alexandre-pereira/ws-trimmer/stl/bobine_ecrou.stl

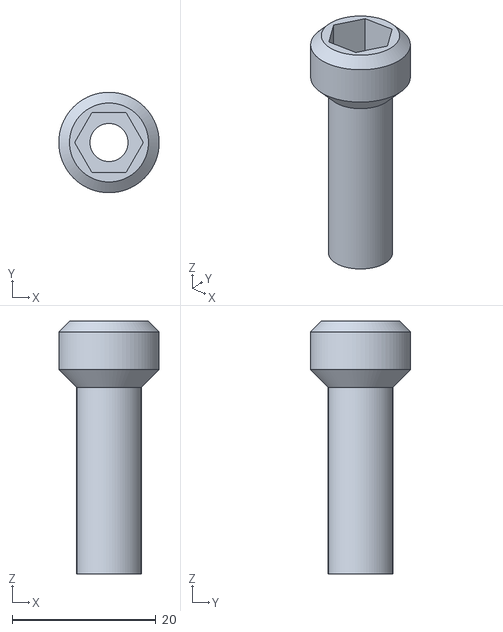
[picture p25: CAD file, 2026-10-21]
stl/bobine_ecrou.stl
14.0 x 14.0 x 35.2
