alexandre-pereira/ws-trimmer/stl/support_laser_leica_x3_x4.stl

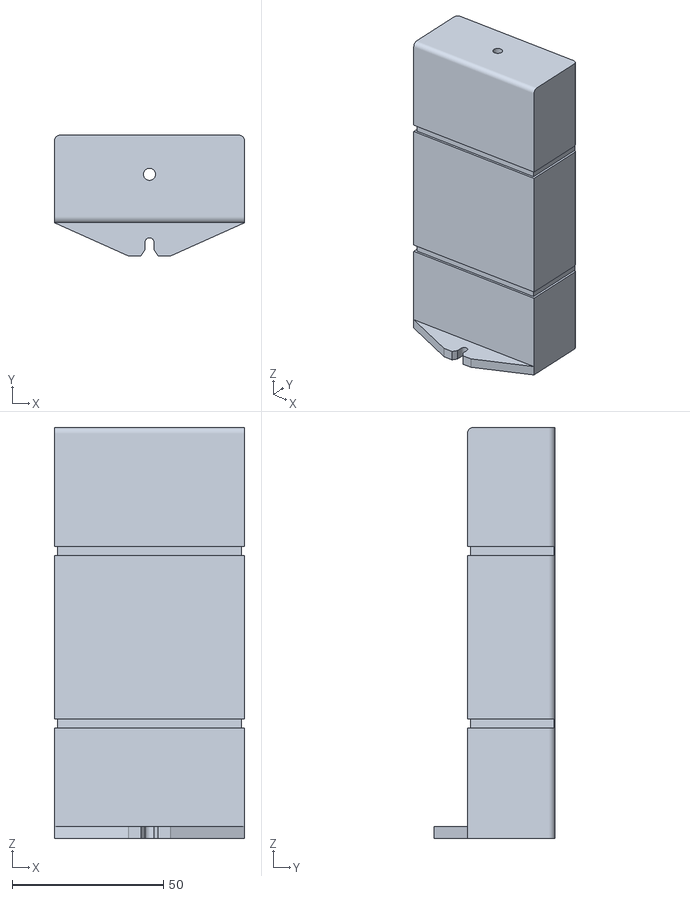
[picture p26: CAD file, 2026-10-21]
stl/support_laser_leica_x3_x4.stl
63.0 x 40.0 x 136.0
