alexandre-pereira/ws-trimmer/stl/support_laser_bosch_plm30.stl

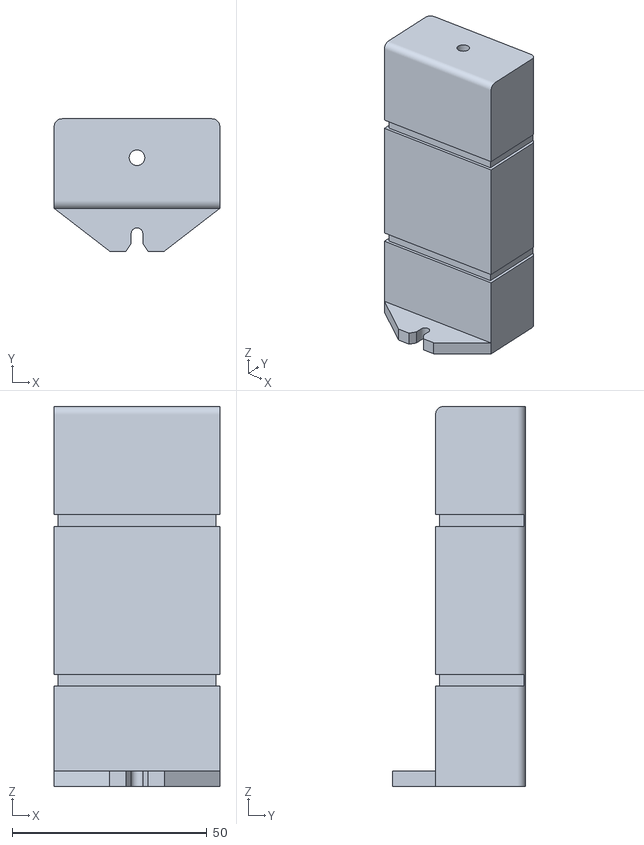
[picture p27: CAD file, 2026-10-21]
stl/support_laser_bosch_plm30.stl
42.5 x 34.0 x 97.5
