alexandre-pereira/ws-trimmer/stl/support_laser_bosch_glm80.stl

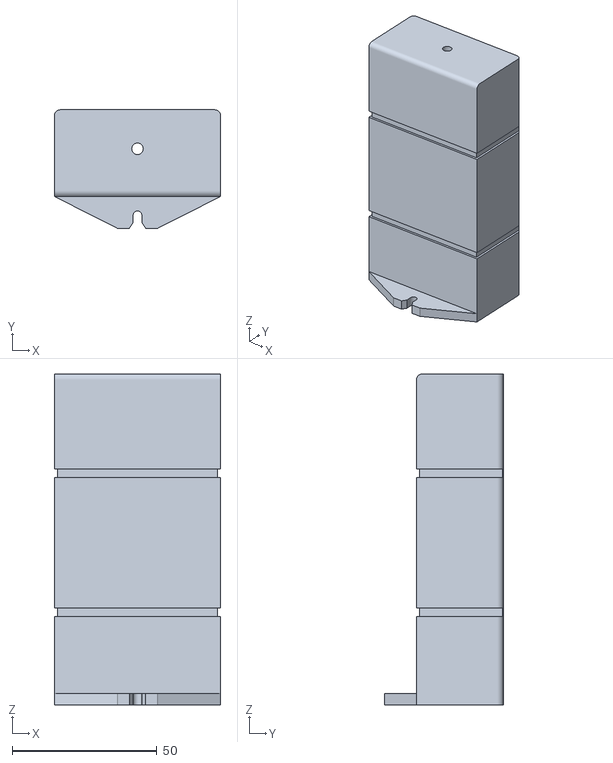
[picture p28: CAD file, 2026-10-21]
stl/support_laser_bosch_glm80.stl
57.5 x 41.0 x 114.5
