alexandre-pereira/ws-trimmer/stl/support_laser_leica_x1.stl

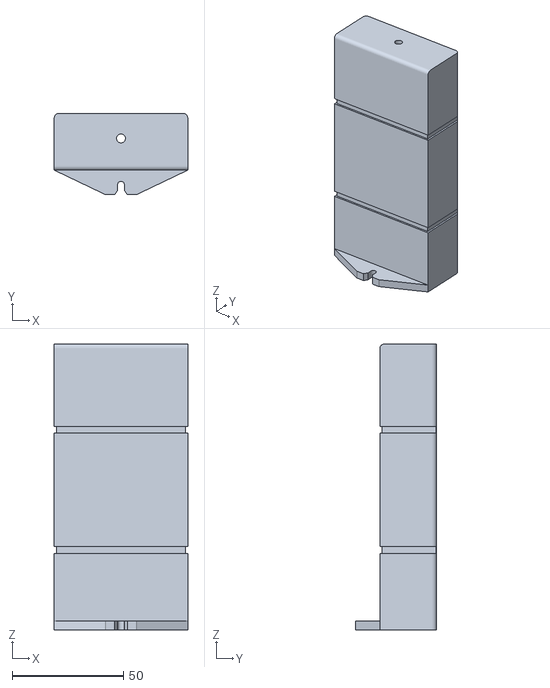
[picture p29: CAD file, 2026-10-21]
stl/support_laser_leica_x1.stl
60.0 x 36.5 x 128.5
