alexandre-pereira/ws-trimmer/stl/support_laser_bosch_glm100_150.stl

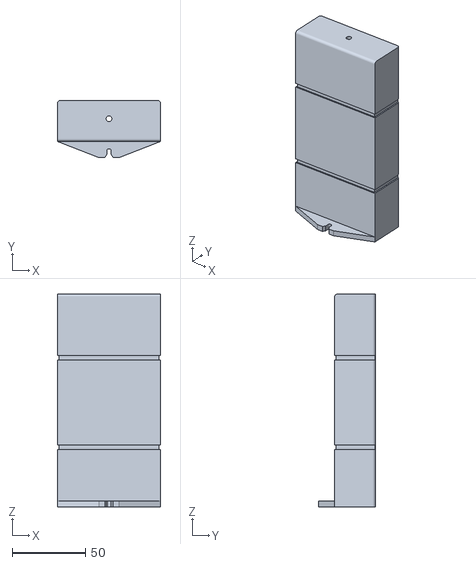
[picture p30: CAD file, 2026-10-21]
stl/support_laser_bosch_glm100_150.stl
70.5 x 39.0 x 145.5
