alexandre-pereira/ws-trimmer/stl/support_laser_bosch_plm70_27.stl

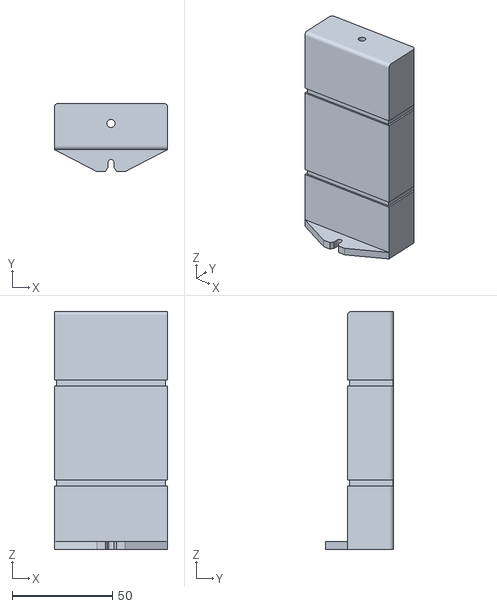
[picture p31: CAD file, 2026-10-21]
stl/support_laser_bosch_plm70_27.stl
56.5 x 34.0 x 118.5
