alexandre-pereira/ws-trimmer/stl/cible.stl

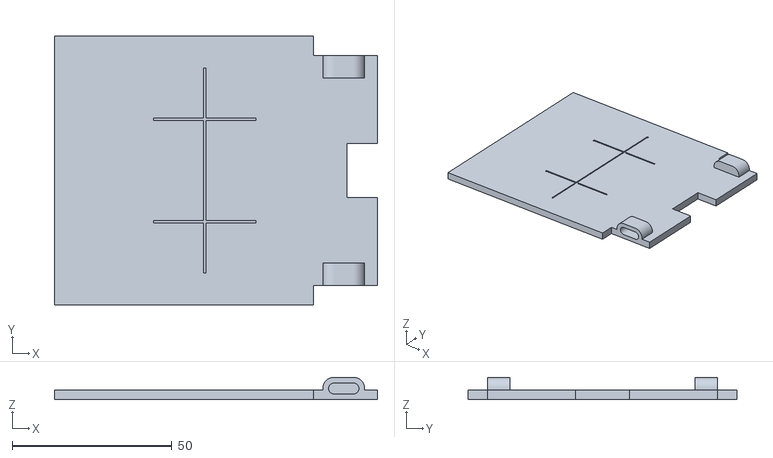
[picture p32: CAD file, 2026-10-21]
stl/cible.stl
101.0 x 84.0 x 7.00
