alexandre-pereira/ws-trimmer/stl/support_laser_leica_d110.stl

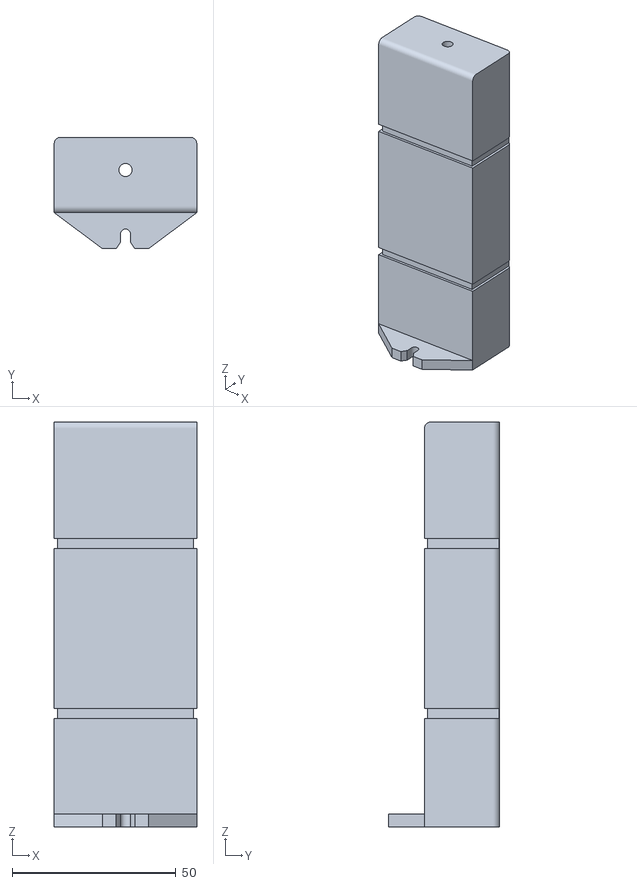
[picture p33: CAD file, 2026-10-21]
stl/support_laser_leica_d110.stl
43.5 x 34.0 x 123.5
