alexandre-pereira/ws-trimmer/stl/poulie.stl

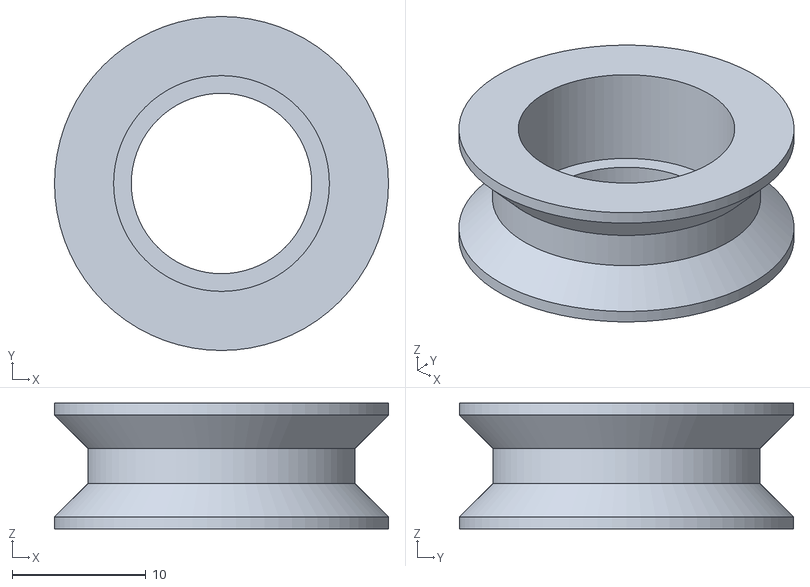
[picture p34: CAD file, 2026-10-21]
stl/poulie.stl
25.0 x 25.0 x 9.40
