alexandre-pereira/ws-trimmer/stl/support_laser_leica_d2_v1.stl

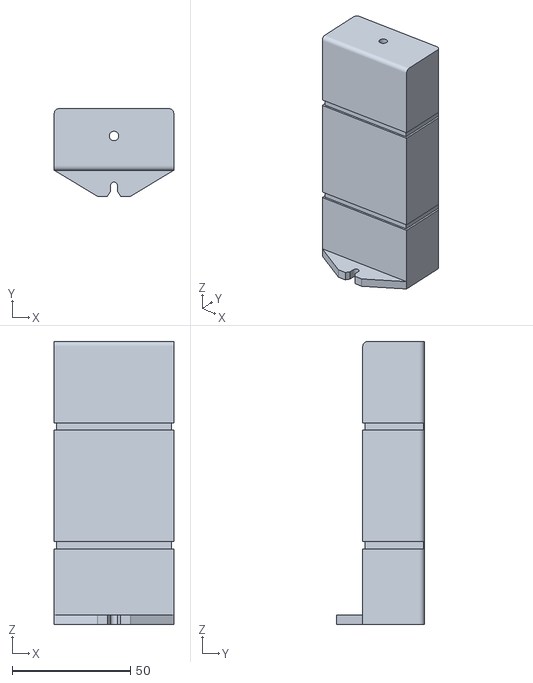
[picture p35: CAD file, 2026-10-21]
stl/support_laser_leica_d2_v1.stl
50.5 x 37.0 x 119.5
