alexandre-pereira/ws-trimmer/stl/entretoises_grappe.stl

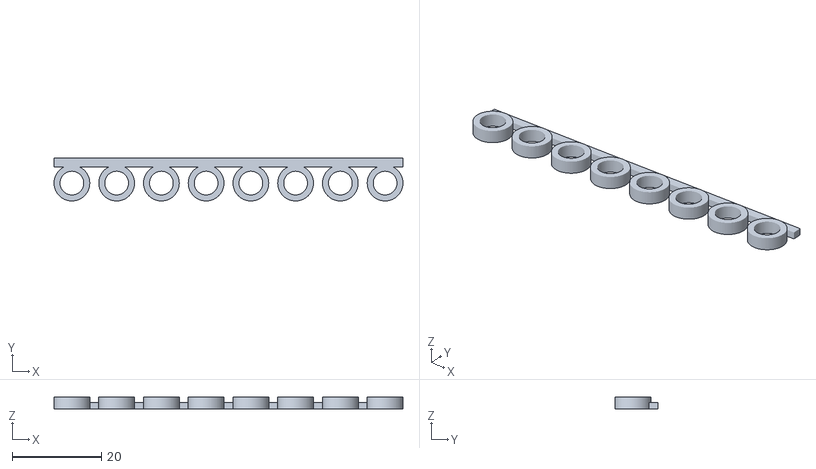
[picture p36: CAD file, 2026-10-21]
stl/entretoises_grappe.stl
78.0 x 9.60 x 2.70
