alexandre-pereira/ws-trimmer/stl/support_laser_bosch_glm40.stl

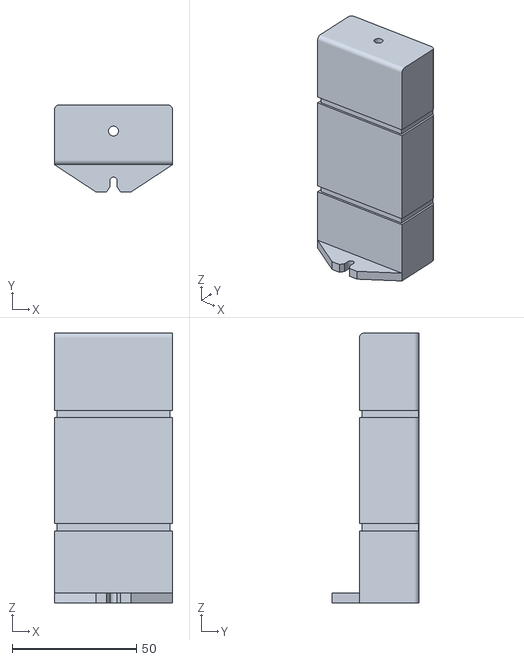
[picture p37: CAD file, 2026-10-21]
stl/support_laser_bosch_glm40.stl
47.5 x 35.0 x 108.5
