alexandre-pereira/ws-trimmer/stl/support_laser_leica_d2_2025.stl

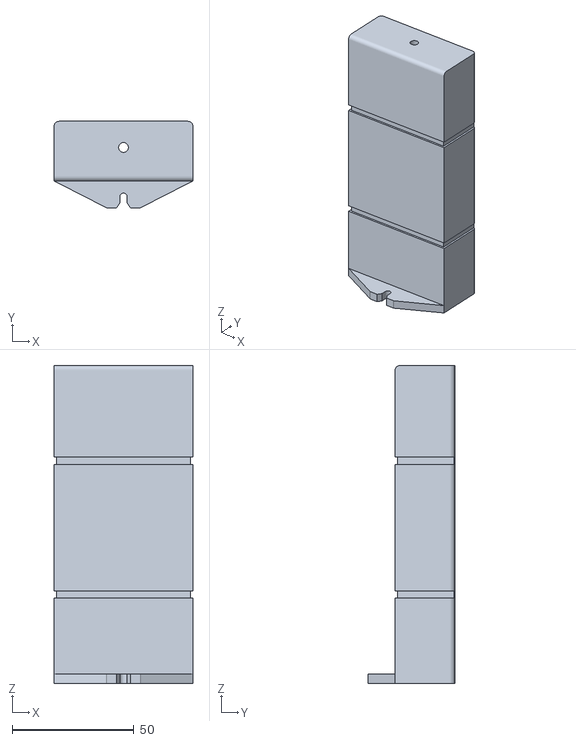
[picture p38: CAD file, 2026-10-21]
stl/support_laser_leica_d2_2025.stl
57.0 x 35.5 x 130.5
