alexandre-pereira/ws-trimmer/stl/support_laser_bosch_zamo.stl

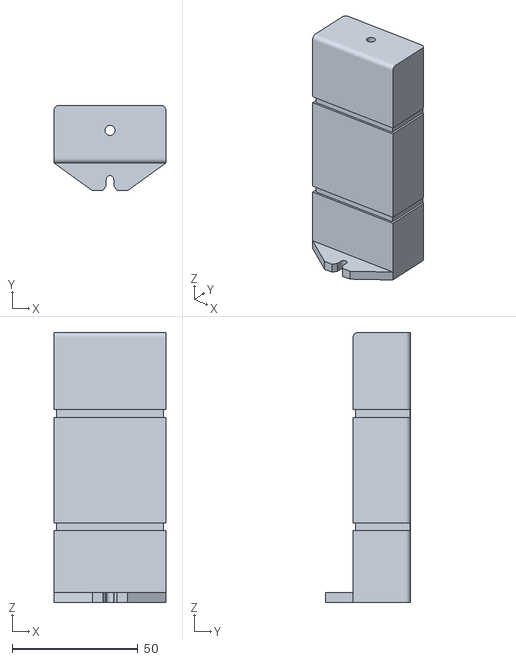
[picture p39: CAD file, 2026-10-21]
stl/support_laser_bosch_zamo.stl
44.5 x 34.0 x 107.5
