alexandre-pereira/ws-trimmer/stl/coulisseau.stl

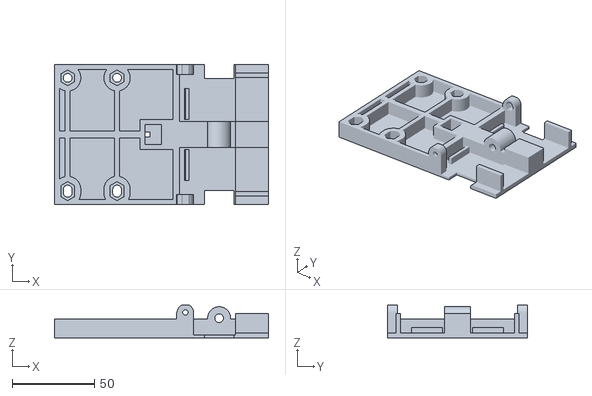
[picture p40: CAD file, 2026-10-21]
stl/coulisseau.stl
130.0 x 84.8 x 20.0
