alexandre-pereira/ws-trimmer/stl/socle.stl

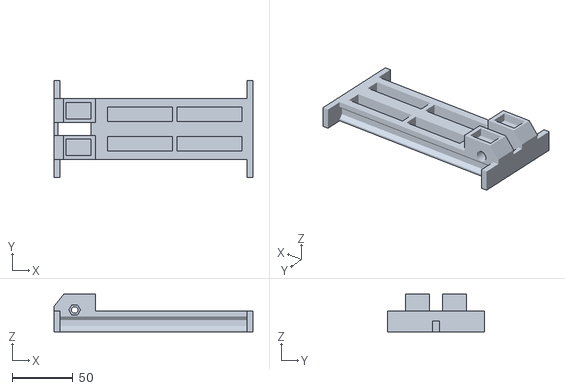
[picture p41: CAD file, 2026-10-21]
stl/socle.stl
163.9 x 80.0 x 31.0
