alexandre-pereira/ws-trimmer/stl/support_laser_bosch_plm40_70.stl

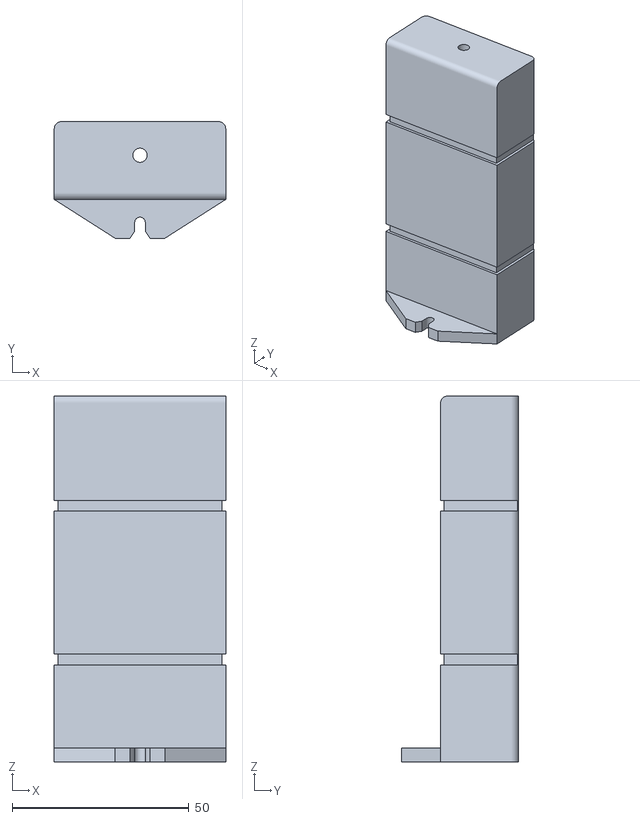
[picture p42: CAD file, 2026-10-21]
stl/support_laser_bosch_plm40_70.stl
48.5 x 33.0 x 103.5
