alexandre-pereira/ws-trimmer/stl/support_laser_bosch_glm50.stl

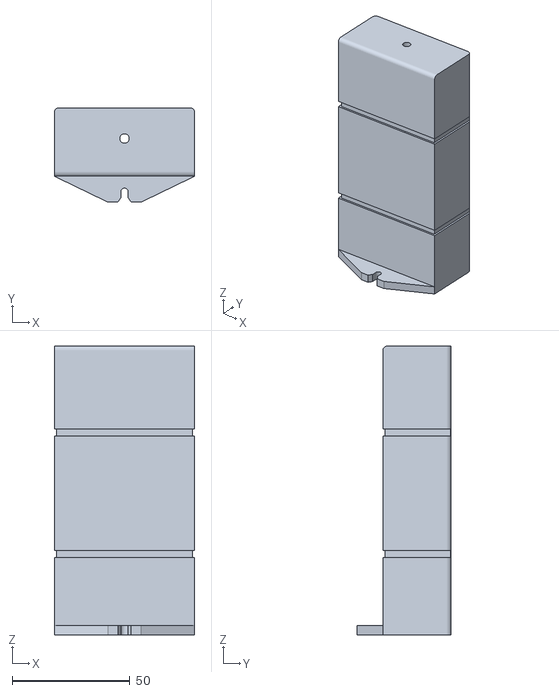
[picture p43: CAD file, 2026-10-21]
stl/support_laser_bosch_glm50.stl
59.5 x 40.0 x 122.5
