alexandre-pereira/ws-trimmer/stl/support_laser_leica_d1.stl

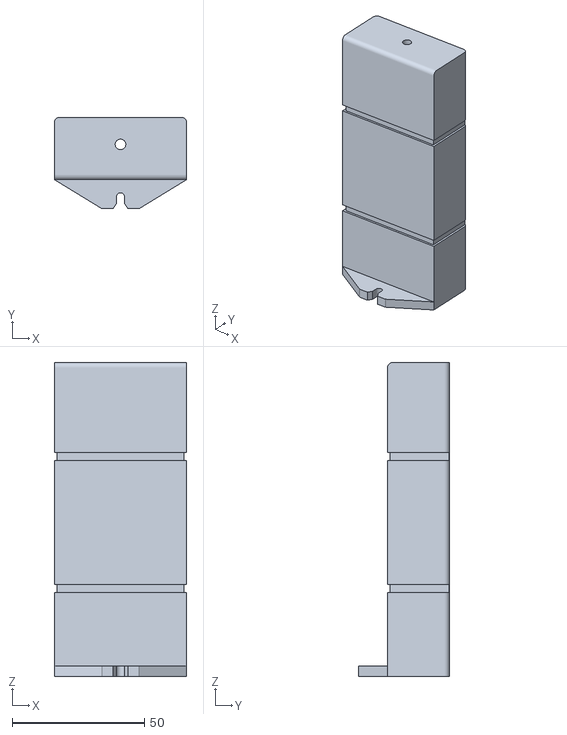
[picture p44: CAD file, 2026-10-21]
stl/support_laser_leica_d1.stl
50.0 x 34.5 x 118.5
