alexandre-pereira/ws-trimmer/(list of files, cad)

Other CAD files:
stl/bobine_tete.stl
scad/banc_149mm.scad
