alexandre-pereira/ws-trimmer/apercu/schema_montage.png

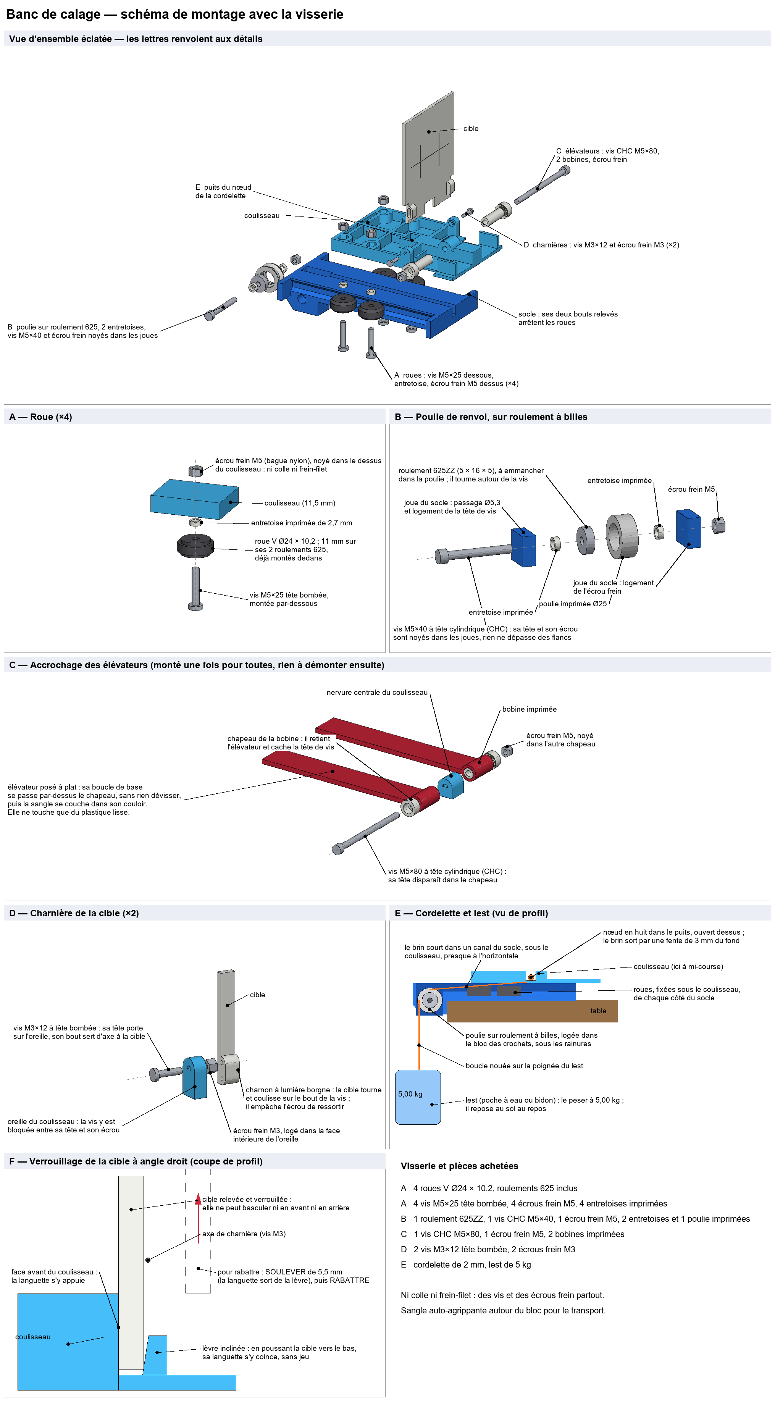
apercu/schema_montage.png
