alexandre-pereira/ws-trimmer/(commit log)

2026-10-18 Banc de calage parapente : modèles sous CERN-OHL-S-2.0, historique repris à zéro
    Modèles OpenSCAD et STL sous CERN-OHL-S-2.0, code sous ISC, images, textes
    et données sous CC BY-SA 4.0 (LICENSE). Premier exemplaire imprimé et essayé
    par l'auteur ; essais limités, sans certification.
    [banc.scad, banc_149mm.scad, bobine_ecrou.stl, bobine_tete.stl, cible.stl, coulisseau.stl, entretoises_grappe.stl, poulie.stl]
2026-10-18 Dépôt renommé ws-trimmer
    [banc.scad, banc_149mm.scad, support_laser.scad]
2026-10-18 Noms des outils WeSoar : WS Trimmer, WS Trim, WS Sounding, WS Viewer ; banc essayé et validé par son auteur
2026-10-19 Site : la charte graphique WeSoar (écume, Literata, bouton ambre, pied de page sur l'ardoise de nuit)
    La feuille commune wesoar.css suit la charte version 4 : fond écume, texte nuit atlantique, accent ambre (foncé en texte sur fond clair), liens océan, cartes à filet sans ombre, pied de page sur l'ardoise de nuit. Literata pour les grands titres, servie avec la page comme Mona Sans, licences OFL notées dans LICENSE, README, NOTES et LISEZMOI.
2026-10-21 Mentions : © 2026 WeSoar, sans « SASU »
    La forme juridique reste dans les mentions légales, où elle est due.
    [banc.scad, banc_149mm.scad, bobine_ecrou.stl, bobine_tete.stl, cible.stl, coulisseau.stl, entretoises_grappe.stl, poulie.stl]
2026-10-22 Logo WeSoar 15-F3 : logo du bandeau et icône de l'onglet
